oldtopman/ardurookie/README.md

ardurookie
====
----
A simple, cheap board for the ATmega328 chips and compatibles.

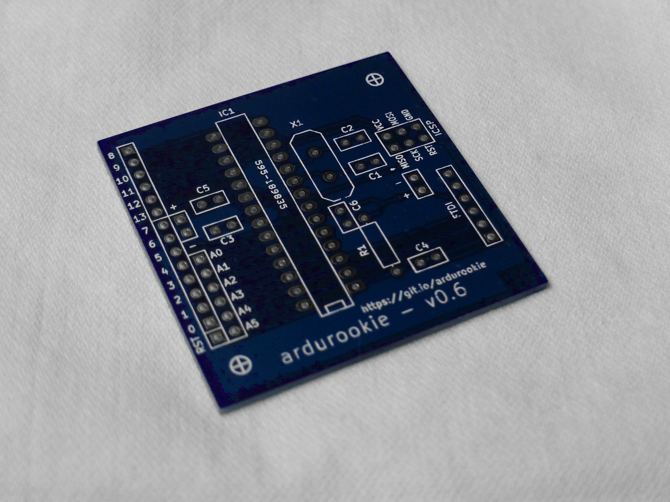
[picture p1: extras/pictures/ardurookie-top-v0.6.jpg]


This is Open Source Hardware, CC-BY-SA 4.0

See docs/overview.txt for more information.
