oldtopman/ardurookie/extras/pictures/ardurookie-bottom-v0.6.jpg

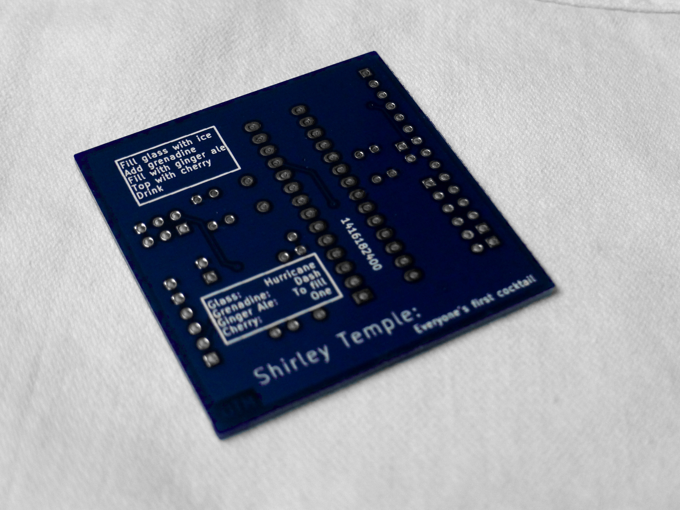
extras/pictures/ardurookie-bottom-v0.6.jpg
