oldtopman/ardurookie/kicad/ardurookie.kicad_pcb

## KiCad design kicad/ardurookie.kicad_pcb (2014-11-29)

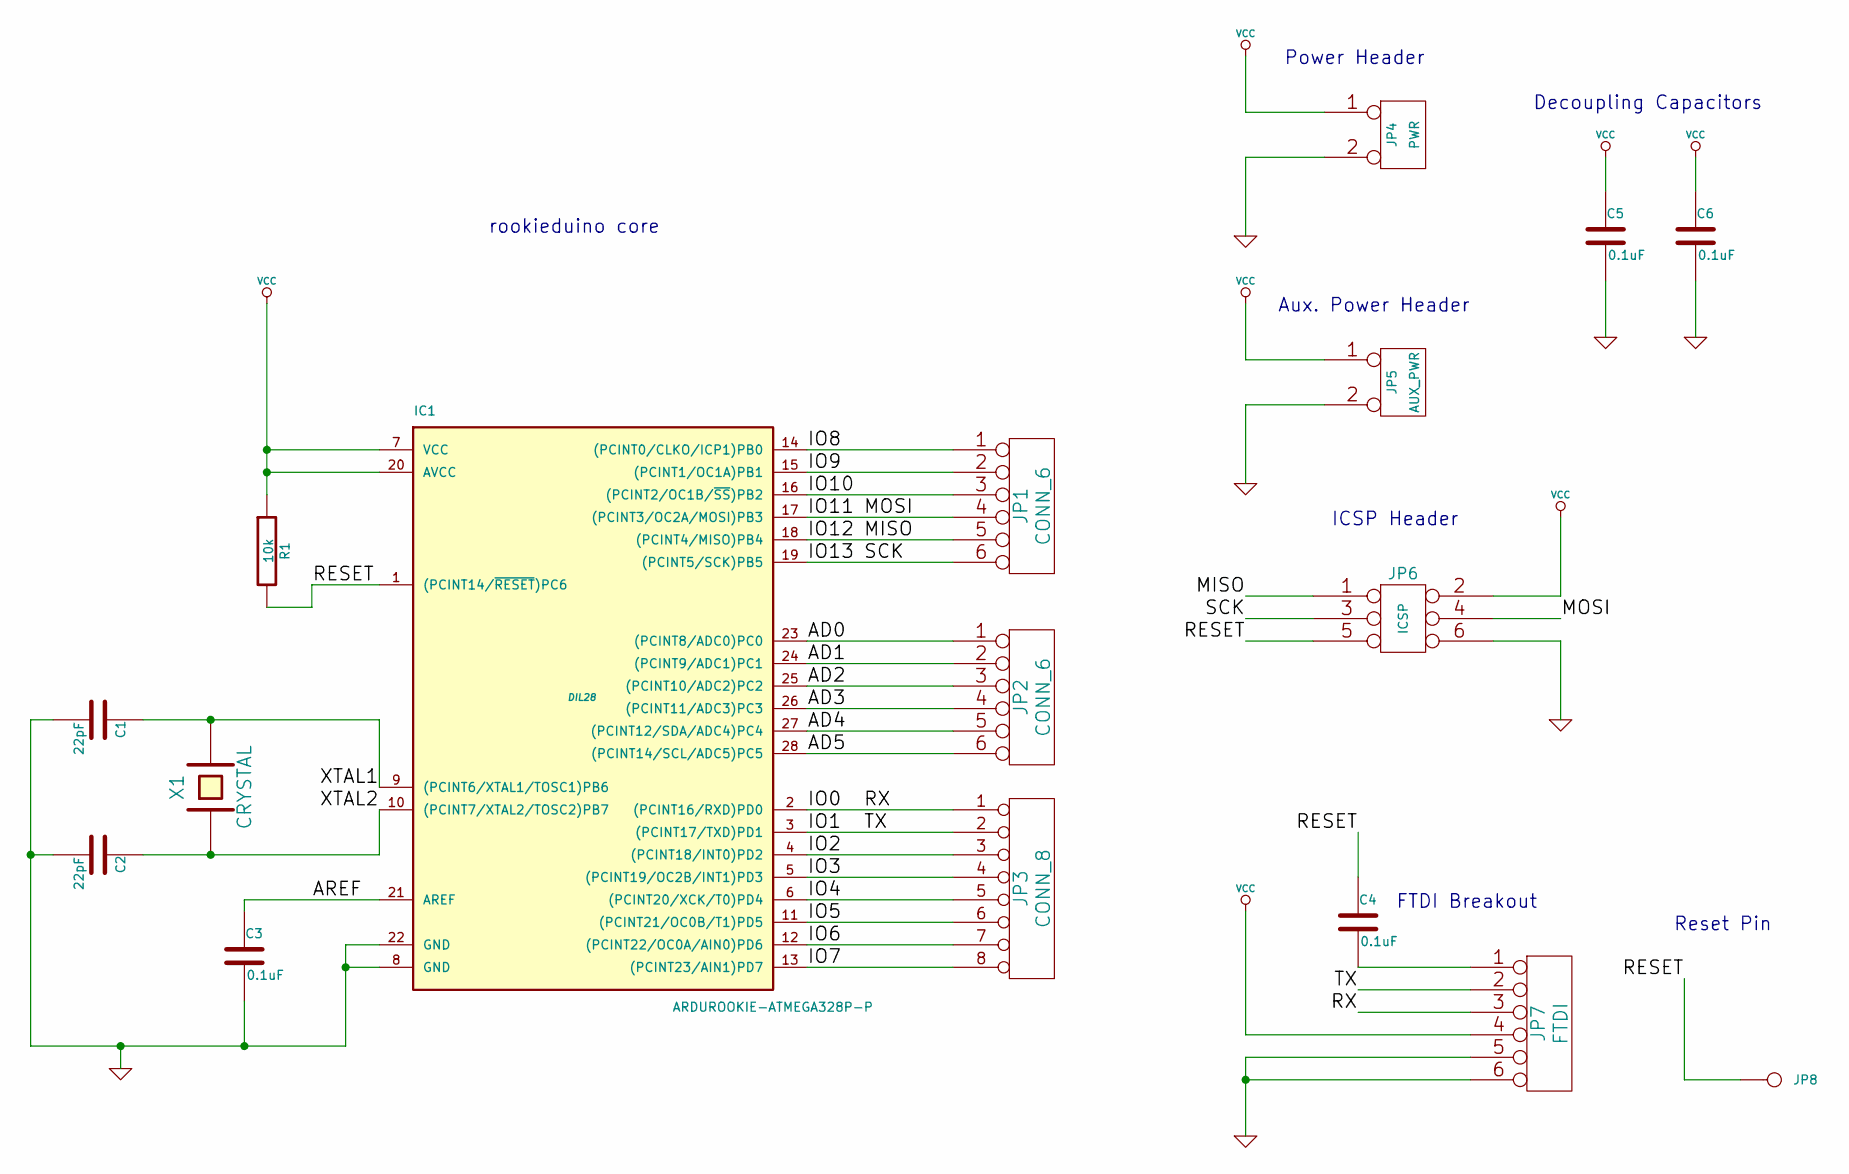
[picture p3: schematic ardurookie.sch]

Parts:
C1, C2: 22pF
C3, C4, C5, C6: 0.1uF
IC1: ARDUROOKIE-ATMEGA328P-P; DIL28
JP1, JP2: CONN_6
JP3: CONN_8
JP4: PWR
JP5: AUX_PWR
JP6: ICSP
JP7: FTDI
JP8: RST
R1: 10k
X1: CRYSTAL

Connections:
/AD0: IC1.23 ((PCINT8/ADC0)PC0), JP2.1
/AD1: IC1.24 ((PCINT9/ADC1)PC1), JP2.2
/AD2: IC1.25 ((PCINT10/ADC2)PC2), JP2.3
/AD3: IC1.26 ((PCINT11/ADC3)PC3), JP2.4
/AD4: IC1.27 ((PCINT12/SDA/ADC4)PC4), JP2.5
/AD5: IC1.28 ((PCINT14/SCL/ADC5)PC5), JP2.6
/AREF: C3.1, IC1.21 (AREF)
/IO0: IC1.2 ((PCINT16/RXD)PD0), JP3.1, JP7.3
/IO1: IC1.3 ((PCINT17/TXD)PD1), JP3.2, JP7.2
/IO2: IC1.4 ((PCINT18/INT0)PD2), JP3.3
/IO3: IC1.5 ((PCINT19/OC2B/INT1)PD3), JP3.4
/IO4: IC1.6 ((PCINT20/XCK/T0)PD4), JP3.5
/IO5: IC1.11 ((PCINT21/OC0B/T1)PD5), JP3.6
/IO6: IC1.12 ((PCINT22/OC0A/AIN0)PD6), JP3.7
/IO7: IC1.13 ((PCINT23/AIN1)PD7), JP3.8
/IO8: IC1.14 ((PCINT0/CLKO/ICP1)PB0), JP1.1
/IO9: IC1.15 ((PCINT1/OC1A)PB1), JP1.2
/IO10: IC1.16 ((PCINT2/OC1B/~SS~)PB2), JP1.3
/IO11: IC1.17 ((PCINT3/OC2A/MOSI)PB3), JP1.4, JP6.4
/IO12: IC1.18 ((PCINT4/MISO)PB4), JP1.5, JP6.1
/IO13: IC1.19 ((PCINT5/SCK)PB5), JP1.6, JP6.3
/RESET: C4.1, IC1.1 ((PCINT14/~RESET~)PC6), JP6.5, JP8.1, R1.2
/XTAL1: C1.1, IC1.9 ((PCINT6/XTAL1/TOSC1)PB6), X1.2
/XTAL2: C2.1, IC1.10 ((PCINT7/XTAL2/TOSC2)PB7), X1.1
GND: C1.2, C2.2, C3.2, C5.2, C6.2, IC1.8 (GND), IC1.22 (GND), JP4.2 (PM), JP5.2 (PM), JP6.6, JP7.5, JP7.6
unnamed: C4.2, JP7.1
VCC: C5.1, C6.1, IC1.7 (VCC), IC1.20 (AVCC), JP4.1, JP5.1, JP6.2, JP7.4, R1.1

Notes on the sheet:
Decoupling Capacitors
Power Header
ICSP Header
FTDI Breakout
rookieduino core
Aux. Power Header
Reset Pin

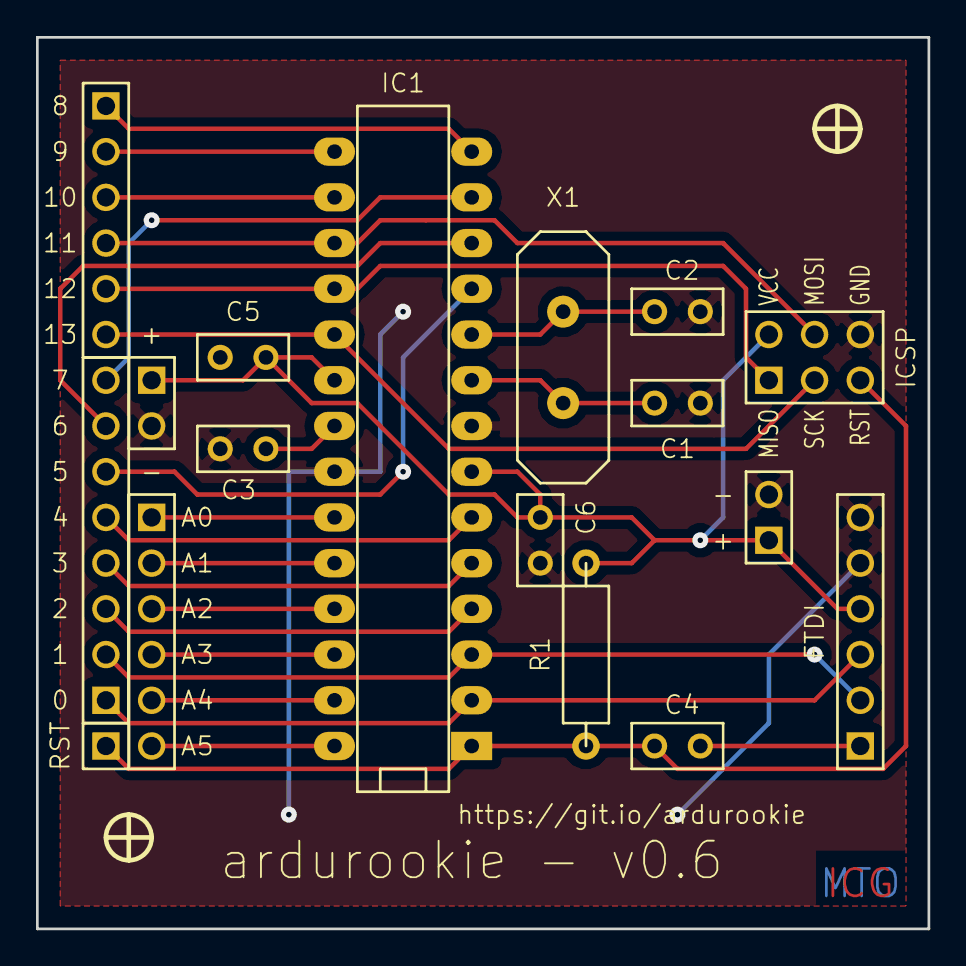
[picture p4: board ardurookie.kicad_pcb from above]

Board: 2 copper layers, 49.5 x 49.5 mm, 17 parts (0 on the bottom side), 27 nets.
